RensselaerMotorsport/Precharge/README.md

# Precharge
Repo For RM's Precharge Board Design
