RensselaerMotorsport/Precharge/PrechargeV3/High_voltage_warning.svg.png

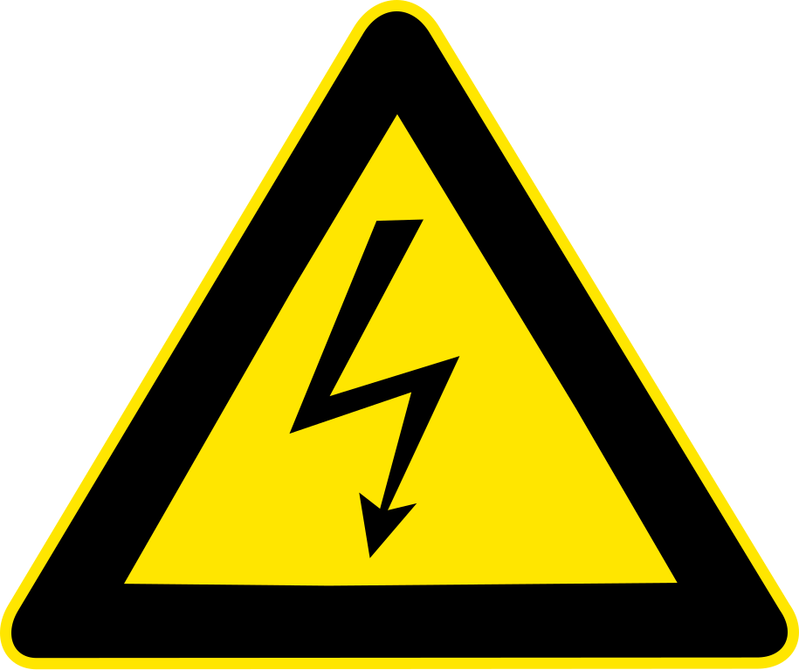
PrechargeV3/High_voltage_warning.svg.png
