RensselaerMotorsport/Precharge/PrechargeV3/HighVoltage.png

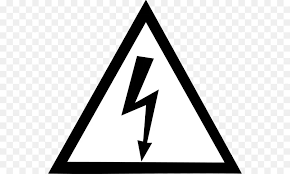
PrechargeV3/HighVoltage.png
