RensselaerMotorsport/Precharge/PrechargeV3/PrechargeV3.kicad_pcb

## KiCad design PrechargeV3/PrechargeV3.kicad_pcb (2026-05-30)

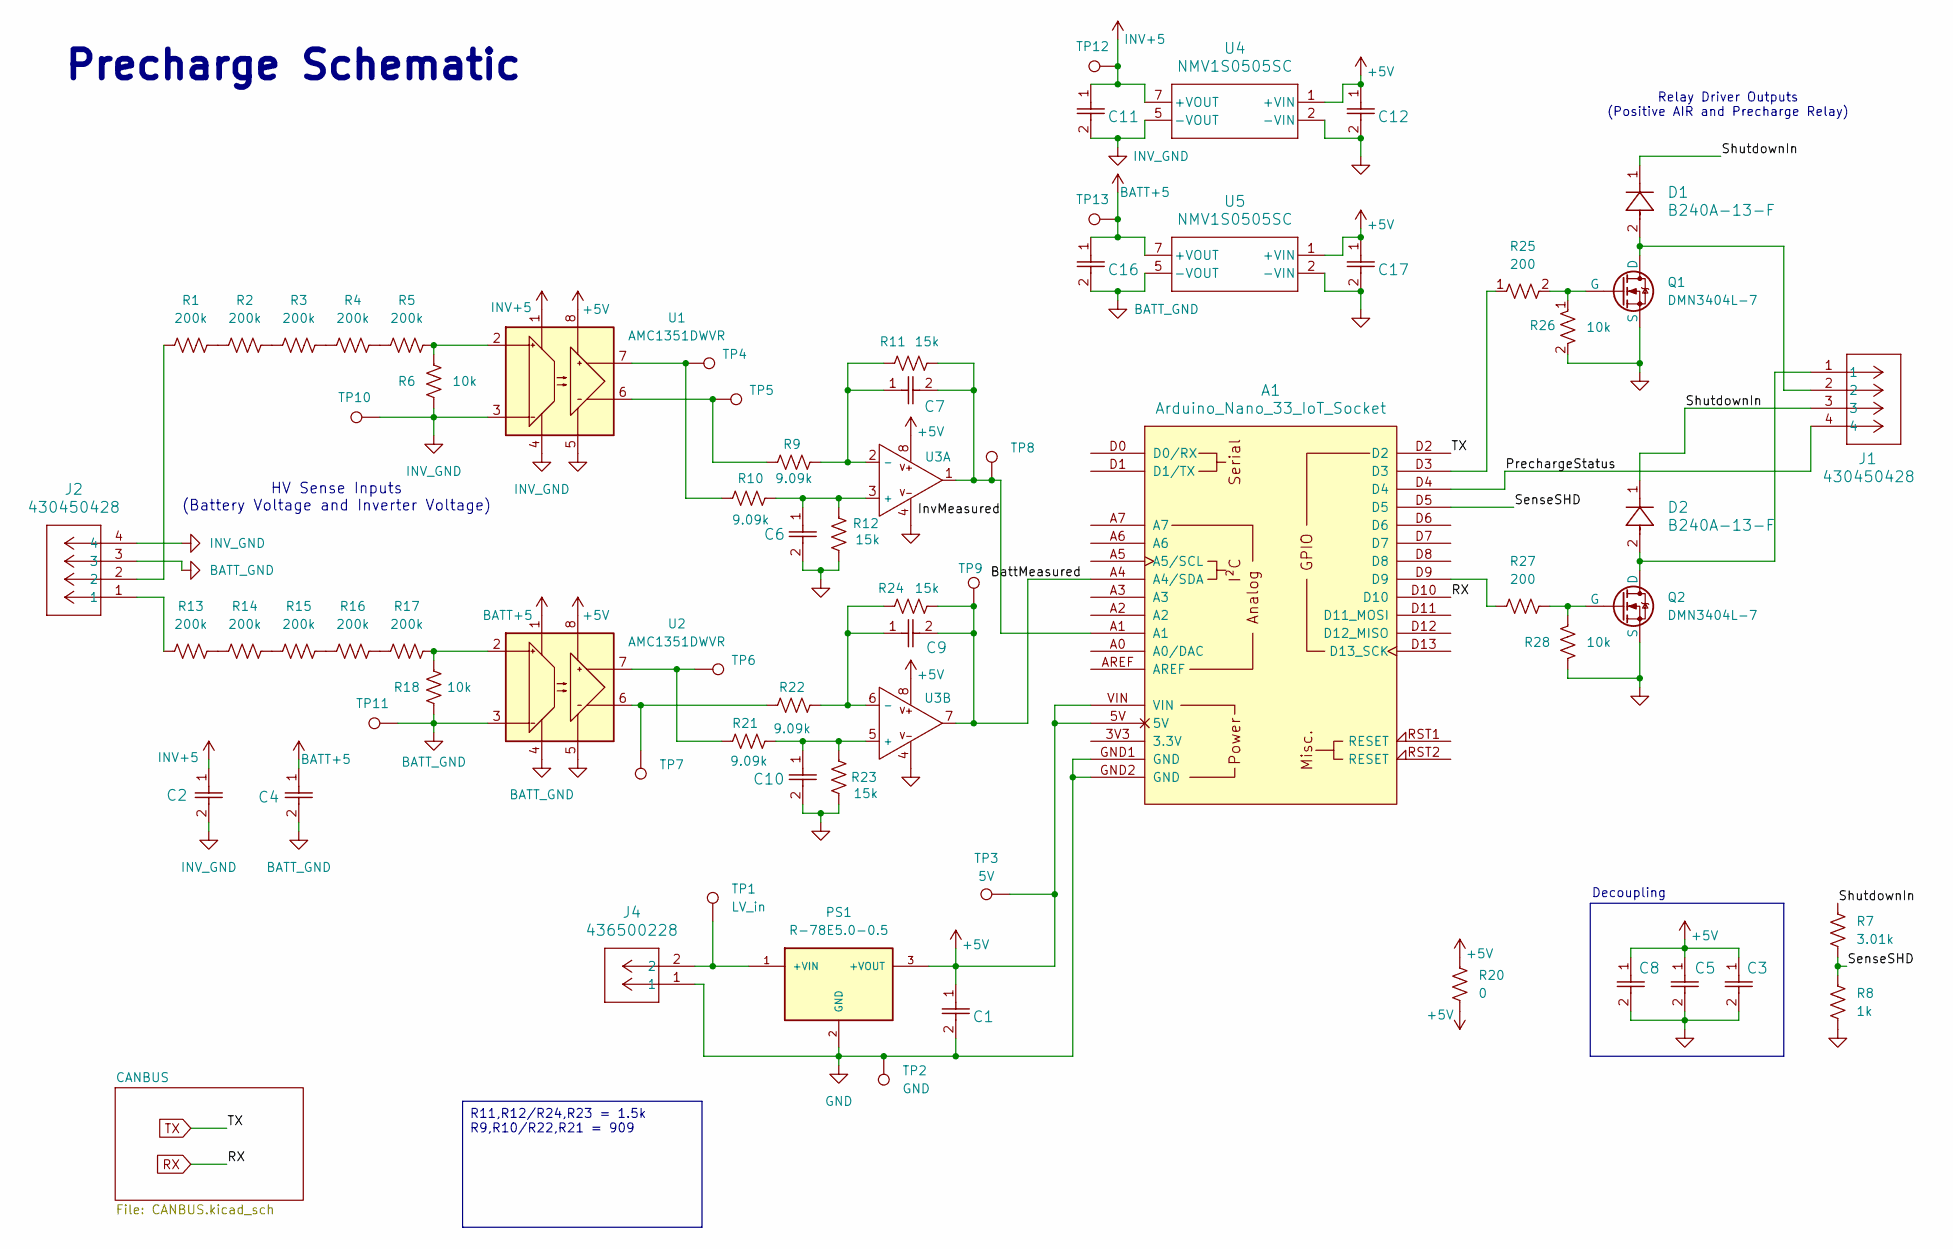
[picture p3: schematic PrechargeV3.kicad_sch, RM29 Precharge PCB]

Parts:
A1: Arduino_Nano_33_IoT_Socket
C1, C11, C12, C16, C17: 10u; C_1210_3225Metric
C2, C3, C4, C5, C8: 1u; C_0805_2012Metric
C6, C7, C9, C10: 330p; C_0603_1608Metric
D1, D2: B240A-13-F; SMA_DIO
J1, J2: 430450428; CONN_SD-43045-010_04_MOL
J4: 436500228; CONN_SD-43650-010_02_MOL
PS1: R-78E5.0-0.5; PARTREV 4
Q1, Q2: DMN3404L-7; SOT23_DIO
R1, R2, R3, R4, R5, R13, R14, R15, R16, R17: 200k; C_0805_2012Metric
R6, R18: 10k; C_0805_2012Metric
R7: 3.01k; R_0603_1608Metric
R8: 1k; R_0603_1608Metric
R9, R10, R21, R22: 9.09k; R_0603_1608Metric
R11, R12, R23, R24: 15k; R_0603_1608Metric
R20: 0; R_0805_2012Metric
R25, R27: 200; R_0603_1608Metric
R26, R28: 10k; R_0603_1608Metric
TP1: LV_in; TestPoint_Pad_D1.0mm
TP2: GND; TestPoint_Pad_D1.0mm
TP3: 5V; TestPoint_Pad_D1.0mm
TP4: Vinv_LV+; TestPoint_Pad_D1.0mm
TP5: Vinv_LV-; TestPoint_Pad_D1.0mm
TP6: Vbatt_LV+; TestPoint_Pad_D1.0mm
TP7: Vbatt_LV-; TestPoint_Pad_D1.0mm
TP8: Inv_measured; TestPoint_Pad_D1.0mm
TP9: Batt_Measured; TestPoint_Pad_D1.0mm
TP10: INV_GND; TestPoint_Pad_D1.0mm
TP11: BATT_GND; TestPoint_Pad_D1.0mm
TP12: INV_+5; TestPoint_Pad_D1.0mm
TP13: BATT_+5; TestPoint_Pad_D1.0mm
U1, U2: AMC1351DWVR; SOIC8_DWV_TEX
U3: TLV9002QDKRQ1; VSSOP8_DGK_TEX
U4, U5: NMV1S0505SC; SIP4_NMV1S0_MUR

Connections:
+5V: A1.5V, A1.VIN, C1.1, C3.1, C5.1, C8.1, C12.1, C17.1, PS1.3 (+VOUT), R20.1, R20.2, TP3.1, U1.8 (VDD2), U2.8 (VDD2), U3.8, U4.1 (+VIN), U5.1 (+VIN)
/BattMeasured: A1.A4 (A4/SDA), C9.2, R24.1, TP9.1, U3.7
/InvMeasured: A1.A1, C7.2, R11.1, TP8.1, U3.1
/PrechargeStatus: A1.D4, J1.4
/SenseSHD: A1.D5, R7.1, R8.2
/ShutdownIn: D1.1, D2.1, J1.3, R7.2
BATT+5: C4.1, C16.1, TP13.1, U2.1 (VDD1), U5.7 (+VOUT)
BATT_GND: C4.2, C16.2, J2.3, R18.1, TP11.1, U2.3 (VINN), U2.4 (GND1), U5.5 (-VOUT)
GND: A1.GND1 (GND), A1.GND2 (GND), C1.2, C3.2, C5.2, C6.2, C8.2, C10.2, C12.2, C17.2, J4.1, PS1.2 (GND), Q1.2 (S), Q2.2 (S), R8.1, R12.1, R23.1, R26.2, R28.2, TP2.1, U1.5 (GND2), U2.5 (GND2), U3.4, U4.2 (-VIN), U5.2 (-VIN); also elsewhere on the board
INV+5: C2.1, C11.1, TP12.1, U1.1 (VDD1), U4.7 (+VOUT)
INV_GND: C2.2, C11.2, J2.4, R6.1, TP10.1, U1.3 (VINN), U1.4 (GND1), U4.5 (-VOUT)
unnamed: A1.D3, R25.1
unnamed: A1.D9, R27.1
unnamed: J2.1, R13.1
unnamed: J2.2, R1.1
unnamed: J4.2, PS1.1 (+VIN), TP1.1
unnamed: D1.2, J1.2, Q1.3 (D)
unnamed: Q1.1 (G), R25.2, R26.1
unnamed: D2.2, J1.1, Q2.3 (D)
unnamed: Q2.1 (G), R27.2, R28.1
unnamed: R1.2, R2.1
unnamed: R2.2, R3.1
unnamed: R3.2, R4.1
unnamed: R4.2, R5.1
unnamed: R13.2, R14.1
unnamed: R14.2, R15.1
unnamed: R15.2, R16.1
unnamed: R16.2, R17.1
unnamed: R5.2, R6.2, U1.2 (VINP)
unnamed: R9.1, TP5.1, U1.6 (VOUTN)
unnamed: R10.1, TP4.1, U1.7 (VOUTP)
unnamed: R17.2, R18.2, U2.2 (VINP)
unnamed: R22.1, TP7.1, U2.6 (VOUTN)
unnamed: R21.1, TP6.1, U2.7 (VOUTP)
unnamed: C6.1, R10.2, R12.2, U3.3 (+)
unnamed: C7.1, R9.2, R11.2, U3.2 (-)
unnamed: C10.1, R21.2, R23.2, U3.5 (+)
unnamed: C9.1, R22.2, R24.2, U3.6 (-)
RX: A1.D10; also elsewhere on the board
TX: A1.D2; also elsewhere on the board

Notes on the sheet:
Precharge Schematic
HV Sense Inputs (Battery Voltage and Inverter Voltage)
Decoupling
Relay Driver Outputs (Positive AIR and Precharge Relay)
R11,R12/R24,R23 = 1.5k R9,R10/R22,R21 = 909

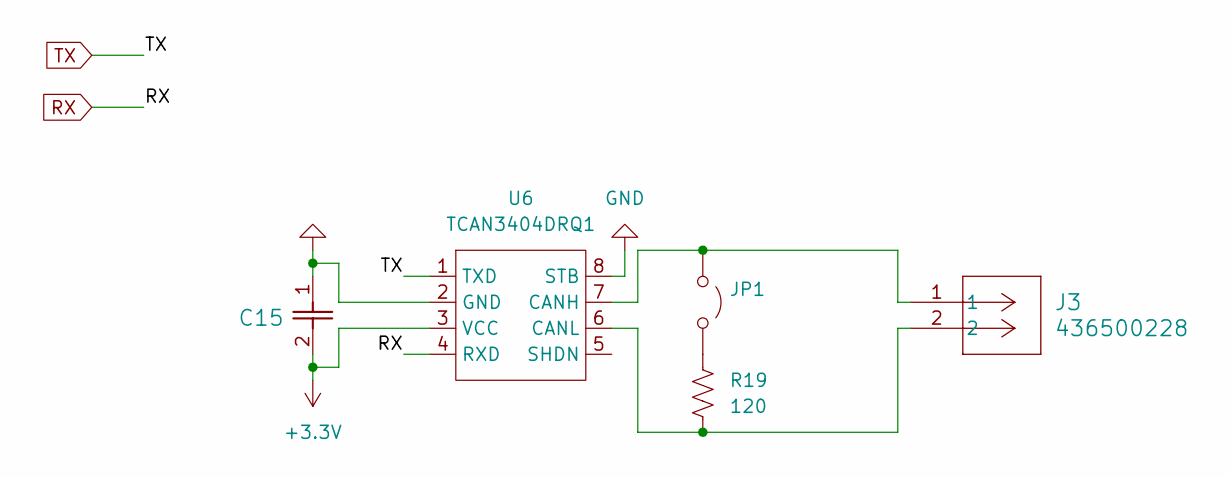
[picture p4: schematic CANBUS.kicad_sch]

Parts:
C15: 1u; C_0805_2012Metric
J3: 436500228; CONN_SD-43650-010_02_MOL
JP1: Jumper_2_Open; PinHeader_1x02_P2.54mm_Vertical
R19: 120; R_0603_1608Metric
U6: TCAN3404DRQ1; SOIC8_D_TEX

Connections:
+3.3V: C15.2, U6.3 (VCC)
GND: C15.1, U6.2 (GND), U6.8 (STB); also elsewhere on the board
unnamed: J3.1, JP1.1 (A), U6.7 (CANH)
unnamed: JP1.2 (B), R19.1
unnamed: J3.2, R19.2, U6.6 (CANL)
RX: U6.4 (RXD); also elsewhere on the board
TX: U6.1 (TXD); also elsewhere on the board

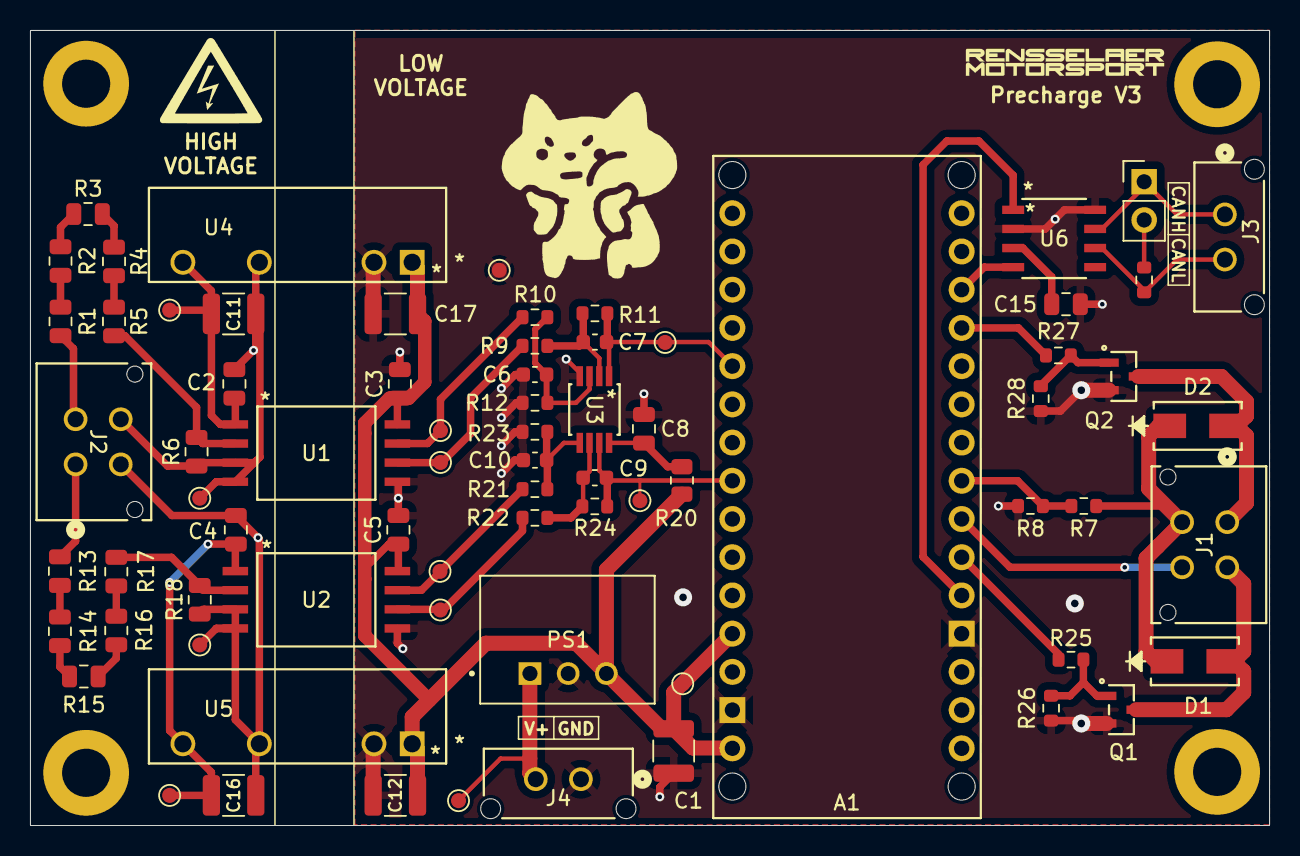
[picture p5: board PrechargeV3.kicad_pcb from above]

Board: 2 copper layers, 82.4 x 52.8 mm, 73 parts (0 on the bottom side), 44 nets.
