RensselaerMotorsport/Precharge/PrechargeCircuit/PrechargeCircuit.kicad_pcb

## KiCad design PrechargeCircuit/PrechargeCircuit.kicad_pcb (2025-07-22)

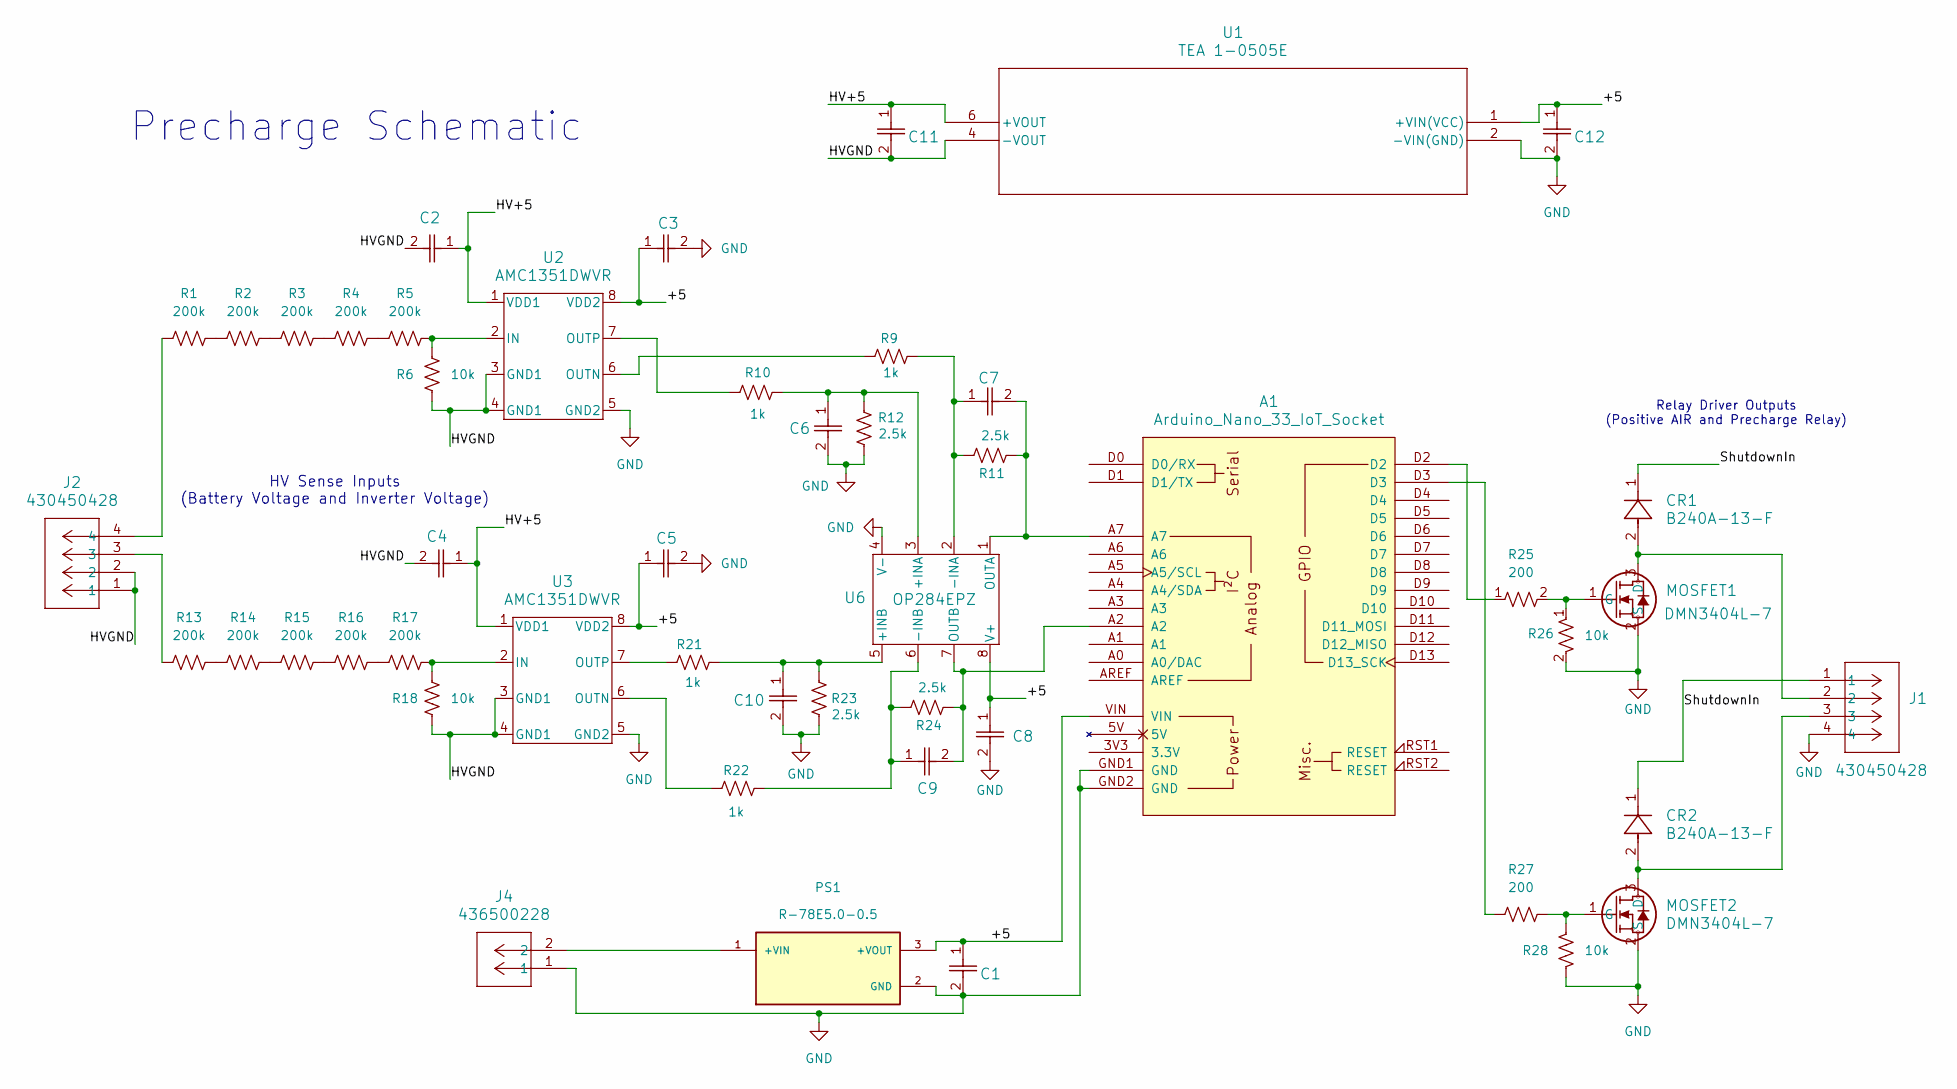
[picture p6: schematic PrechargeCircuit.kicad_sch, RM28 Precharge PCB]

Parts:
A1: Arduino_Nano_33_IoT_Socket
C1, C11, C12: C324C106K3R5TA; CAP_C324C_MR_X7R_KEM
C2, C3, C4, C5, C8: K104K10X7RF5UH5; K104K10X7RF5UH5_VIS
C6, C7, C9, C10: K331K15X7RF5TL2; CAP_K-SERIES_15-L2_VIS
CR1, CR2: B240A-13-F; SMA_DIO-L
J1, J2: 430450428; CONN_SD-43045-010_04_MOL
J4: 436500228; CONN_SD-43650-010_02_MOL
MOSFET1, MOSFET2: DMN3404L-7; SOT23_DIO-L
PS1: R-78E5.0-0.5; CONV_R-78E5.0-0.5; PARTREV 4
R1, R2, R3, R4, R5, R13, R14, R15, R16, R17: 200k; R_Axial_DIN0207_L6.3mm_D2.5mm_P10.16mm_Horizontal
R6, R18, R26, R28: 10k; R_Axial_DIN0207_L6.3mm_D2.5mm_P10.16mm_Horizontal
R9, R10, R21, R22: 1k; R_Axial_DIN0207_L6.3mm_D2.5mm_P10.16mm_Horizontal
R11, R12, R23, R24: 2.5k; R_Axial_DIN0207_L6.3mm_D2.5mm_P10.16mm_Horizontal
R25, R27: 200; R_Axial_DIN0207_L6.3mm_D2.5mm_P10.16mm_Horizontal
U1: TEA 1-0505E; TEA 1E_TRP
U2, U3: AMC1351DWVR; SOIC8_DWV_TEX
U6: OP284EPZ; N_8_ADI

Connections:
/+5: A1.VIN, C1.1, C3.1, C5.1, C8.1, C12.1, PS1.3 (+VOUT), U1.1 (+VIN(VCC)), U2.8 (VDD2), U3.8 (VDD2), U6.8 (V+)
/HV+5: C2.1, C4.1, C11.1, U1.6 (+VOUT), U2.1 (VDD1), U3.1 (VDD1)
/SenseSHD: A1.D4; also elsewhere on the board
/ShutdownIn: CR1.1, CR2.1, J1.1; also elsewhere on the board
GND: A1.GND1 (GND), A1.GND2 (GND), C1.2, C3.2, C5.2, C6.2, C8.2, C10.2, C12.2, J1.4, J4.1, MOSFET1.2 (S), MOSFET2.2 (S), PS1.2 (GND), R12.1, R23.1, R26.2, R28.2, U1.2 (-VIN(GND)), U2.5 (GND2), U3.5 (GND2), U6.4 (V-); also elsewhere on the board
unnamed: A1.D2, R25.1
unnamed: A1.D3, R27.1
unnamed: J2.3, R13.1
unnamed: J2.4, R1.1
unnamed: CR1.2, J1.2, MOSFET1.3 (D)
unnamed: MOSFET1.1 (G), R25.2, R26.1
unnamed: CR2.2, J1.3, MOSFET2.3 (D)
unnamed: MOSFET2.1 (G), R27.2, R28.1
unnamed: J4.2, PS1.1 (+VIN)
unnamed: R1.2, R2.1
unnamed: R2.2, R3.1
unnamed: R3.2, R4.1
unnamed: R4.2, R5.1
unnamed: R13.2, R14.1
unnamed: R14.2, R15.1
unnamed: R15.2, R16.1
unnamed: R16.2, R17.1
unnamed: R5.2, R6.2, U2.2 (IN)
unnamed: R9.1, U2.6 (OUTN)
unnamed: R10.1, U2.7 (OUTP)
unnamed: R17.2, R18.2, U3.2 (IN)
unnamed: R22.1, U3.6 (OUTN)
unnamed: R21.1, U3.7 (OUTP)
unnamed: C6.1, R10.2, R12.2, U6.3 (+INA)
unnamed: C10.1, R21.2, R23.2, U6.5 (+INB)
unnamed: C7.1, R9.2, R11.2, U6.2 (-INA)
unnamed: C9.1, R22.2, R24.2, U6.6 (-INB)
unnamed: A1.A7, C7.2, R11.1, U6.1 (OUTA)
unnamed: A1.A2, C9.2, R24.1, U6.7 (OUTB)

Notes on the sheet:
Precharge Schematic
HV Sense Inputs (Battery Voltage and Inverter Voltage)
Relay Driver Outputs (Positive AIR and Precharge Relay)

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
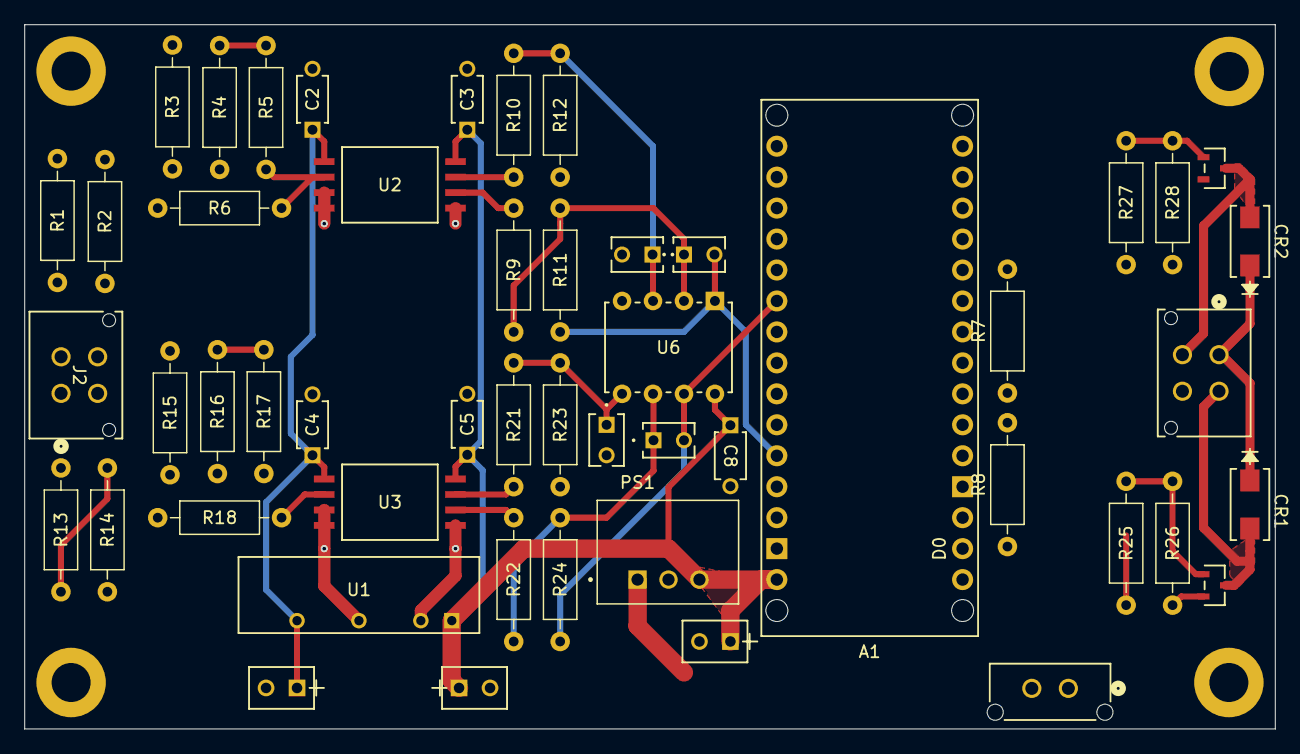
[picture p7: board PrechargeCircuit.kicad_pcb from above]

Board: 2 copper layers, 102.6 x 57.8 mm, 51 parts (0 on the bottom side), 35 nets.

Other parts of the board:
R7, R8: R_US; R_Axial_DIN0207_L6.3mm_D2.5mm_P10.16mm_Horizontal

Their connections:
/SenseSHD: R7.1, R8.2; also elsewhere on the board
/ShutdownIn: R7.2; also elsewhere on the board
GND: R8.1; also elsewhere on the board
