RensselaerMotorsport/Precharge/Code/V3/Core/Src/main.c

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
/* Includes ------------------------------------------------------------------*/
#include "main.h"

/* USER CODE BEGIN Includes */
#include "config.h"
#include "stdio.h"
/* USER CODE END Includes */

ADC_HandleTypeDef hadc;
DMA_HandleTypeDef hdma_adc;

CAN_HandleTypeDef hcan;

TIM_HandleTypeDef htim1;

UART_HandleTypeDef huart2;

/* USER CODE BEGIN PV */
uint32_t analogBuf[4]; //array for analog dma values
char buf[40]; //buffer for serial prints
uint8_t sample = 0; //toggle variable for adc callback
uint16_t invRaw = 0;
uint16_t battRaw = 0;
float invVolt = 0.0;
float battVolt = 0.0;
float diffVolt = 0.0;
uint8_t state = 0;
uint8_t ioSate = 0;
/* USER CODE END PV */

void SystemClock_Config(void);
static void MX_GPIO_Init(void);
static void MX_DMA_Init(void);
static void MX_USART2_UART_Init(void);
static void MX_ADC_Init(void);
static void MX_CAN_Init(void);
static void MX_TIM1_Init(void);
/* USER CODE BEGIN PFP */
void HAL_ADC_ConvCpltCallback(ADC_HandleTypeDef* hadc);
void stringFormat(float v1, float v2, int s,char* res);
/* USER CODE END PFP */

/**
  * @brief  The application entry point.
  * @retval int
  */
int main(void)
{

  /* MCU Configuration--------------------------------------------------------*/

  /* Reset of all peripherals, Initializes the Flash interface and the Systick. */
  HAL_Init();

  /* Configure the system clock */
  SystemClock_Config();

  /* Initialize all configured peripherals */
  MX_GPIO_Init();
  MX_DMA_Init();
  MX_USART2_UART_Init();
  MX_ADC_Init();
  MX_CAN_Init();
  MX_TIM1_Init();
  /* USER CODE BEGIN 2 */


	HAL_ADCEx_Calibration_Start(&hadc);
	HAL_TIM_Base_Start(&htim1);
	HAL_ADC_Start_DMA(&hadc,analogBuf,2);

	if(SERIAL_TX)
	{
	  HAL_UART_Transmit(&huart2,(uint8_t*)"Precharge V3.0",18,100);
	}
	//Can Configuration
	HAL_CAN_Start(&hcan);
	uint8_t canData[5];
	uint32_t mailbox;

	CAN_TxHeaderTypeDef canConfig;
	canConfig.StdId = 0x20; // standard id
	canConfig.ExtId = 0x00; //extended id
	canConfig.IDE = CAN_ID_STD; //specify standard id
	canConfig.RTR = CAN_RTR_DATA; //specify data frame, not remote
	canConfig.DLC = 0x05; //number of data bytes
	canConfig.TransmitGlobalTime = DISABLE; //no timestamp

  /* USER CODE END 2 */

  /* Infinite loop */
  /* USER CODE BEGIN WHILE */
  while (1)
  {

	 if(sample == 1)
	 {
		 //adc sample completed
		 //runs at 5Hz

		 sample = 0;

		 //calculate voltages
		 //battVolt = (3.3/4096) * 101 * battRaw; // (3.3/4095) * (R1+R2)/R2 * adc measurement
		 //invVolt = (3.3/4096) * 101 * invRaw;
		 battVolt = (3.3/4096) * battRaw;
		 invVolt = (3.3/4096) * invRaw;

		 diffVolt = battRaw - invRaw;

		 //uart and can transmit
		 if(SERIAL_TX)
		 {
			 sprintf(buf,"Battery: %d Inverter: %d State: %d\r\n",(int)(battVolt*100),(int)(invVolt*100),state);
			 HAL_UART_Transmit(&huart2,(uint8_t*)buf,40,100);
		 }
		 if(CAN_TX)
		 {
			 //float x100 to transmit 2 decimal places of voltage
			 canData[0] = ((int)(battVolt * 100)) >>8;
			 canData[1] = ((int)(battVolt * 100)) &0xFF;
			 canData[2] = ((int)(invVolt * 100)) >>8;
			 canData[3] = ((int)(invVolt * 100)) &0xFF;
			 canData[4] = state;
			 HAL_CAN_AddTxMessage(&hcan,&canConfig,canData,&mailbox);
		 }

		 //precharge logic
		 switch(state)
		 {
		 case 0:
			 //idle
			 if(battVolt < BATT_THRESH)
			 {
				 state = 3;
			 }
			 else if(HAL_GPIO_ReadPin(Shd_Sense_GPIO_Port,Shd_Sense_Pin) == 1)
			 {
				 state = 1;
			 }
			 else
			 {
				 HAL_GPIO_WritePin(Air_Relay_GPIO_Port,Air_Relay_Pin,GPIO_PIN_RESET);
				 HAL_GPIO_WritePin(Pcg_Relay_GPIO_Port,Pcg_Relay_Pin,GPIO_PIN_RESET);
			 }
			 break;
		 case 1:
			 //charging
			 if(HAL_GPIO_ReadPin(Shd_Sense_GPIO_Port,Shd_Sense_Pin) == 0)
			 {
				 state = 0;
			 }
			 else if(diffVolt<=0.05)
			 {
				 state = 2;
			 }
			 else
			 {
				 HAL_GPIO_WritePin(Air_Relay_GPIO_Port,Air_Relay_Pin,GPIO_PIN_RESET);
				 HAL_GPIO_WritePin(Pcg_Relay_GPIO_Port,Pcg_Relay_Pin,GPIO_PIN_SET);
			 }
			 break;
		 case 2:
			 //running
			 if(HAL_GPIO_ReadPin(Shd_Sense_GPIO_Port,Shd_Sense_Pin) == 0)
			 {
				 state = 0;
			 }
			 else
			 {
				 HAL_GPIO_WritePin(Air_Relay_GPIO_Port,Air_Relay_Pin,GPIO_PIN_SET);
				 HAL_GPIO_WritePin(Pcg_Relay_GPIO_Port,Pcg_Relay_Pin,GPIO_PIN_RESET);
			 }
			 break;
		 }

	 }

    /* USER CODE END WHILE */

    /* USER CODE BEGIN 3 */
  }
  /* USER CODE END 3 */
}

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
/* USER CODE BEGIN 4 */
void HAL_ADC_ConvCpltCallback(ADC_HandleTypeDef* hadc)
{
	invRaw = (uint16_t)analogBuf[0];
	battRaw = (uint16_t)analogBuf[1];
	sample = 1;
}
//alternative to sprintf to format uart message - saves lots of ram

/* USER CODE END 4 */
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
