RensselaerMotorsport/Precharge/Code/V3/Core/Inc/main.h

#define MCO_Pin GPIO_PIN_0
#define MCO_GPIO_Port GPIOF
#define INV_Pin GPIO_PIN_1
#define INV_GPIO_Port GPIOA
#define VCP_TX_Pin GPIO_PIN_2
#define VCP_TX_GPIO_Port GPIOA
#define Batt_Pin GPIO_PIN_5
#define Batt_GPIO_Port GPIOA
#define Air_Relay_Pin GPIO_PIN_0
#define Air_Relay_GPIO_Port GPIOB
#define Pcg_Relay_Pin GPIO_PIN_8
#define Pcg_Relay_GPIO_Port GPIOA
#define SWDIO_Pin GPIO_PIN_13
#define SWDIO_GPIO_Port GPIOA
#define SWCLK_Pin GPIO_PIN_14
#define SWCLK_GPIO_Port GPIOA
#define VCP_RX_Pin GPIO_PIN_15
#define VCP_RX_GPIO_Port GPIOA
#define Shd_Sense_Pin GPIO_PIN_6
#define Shd_Sense_GPIO_Port GPIOB
