RensselaerMotorsport/Precharge/(commit log)

2025-05-07 Precharge V1
    [PrechargeCircuit.kicad_pcb, PrechargeCircuit.kicad_sch]
2026-03-18 Updated Schematic For ESF
    [CANBUS.kicad_sch, PrechargeV2.kicad_sch]
2026-03-22 Started Precharge V3
    [CANBUS.kicad_sch, PrechargeCircuit.kicad_sch, PrechargeV3.kicad_pcb, PrechargeV3.kicad_sch]
2026-03-27 Started Layout
    [CANBUS.kicad_sch, PrechargeV3.kicad_pcb, PrechargeV3.kicad_sch]
2026-03-31 Finished Layout
    [CANBUS.kicad_sch, PrechargeV3.kicad_pcb, PrechargeV3.kicad_sch]
2026-04-02 Updated Layout
    [CANBUS.kicad_sch, PrechargeV3.kicad_pcb, PrechargeV3.kicad_sch]
2026-05-26 Precharge V3.0 STM32 code
    Precharge control software for version 3.0 of the precharge board using an stm32f0 nucleo board.
2026-05-30 Precharge state machine & 3.3v component adjustments
    Precharge state machine written for stm32. Differential op-amp and shutdown sense resistor values changed from 5v logic level mcu to 3.3v one.
    [PrechargeV3.kicad_pcb, PrechargeV3.kicad_sch]
